huettern/ekg3000-hardware/README.md

EKG-3000 Hardware design
========================

Designed using CADSoft Eagle
