huettern/ekg3000-hardware/05_BOM/BOM_EKG3000.pdf

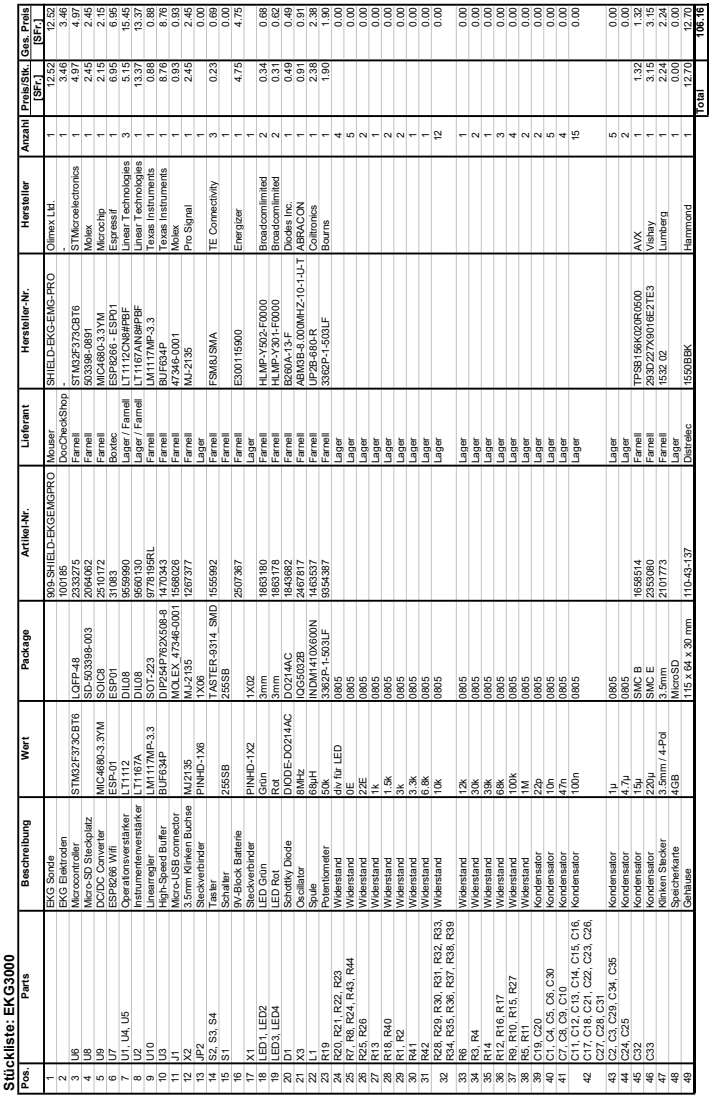
[picture p1: page 1]

Preis/Stk. Ges. Preis

1 EKG Sonde 909-SHIELD-EKGEMGPRO Mouser SHIELD-EKG-EMG-PRO Olimex Ltd. 1 12.52 12.52

3 U6 Microcontroller STM32F373CBT6 LQFP-48 2333275 Farnell STM32F373CBT6 STMicroelectronics 1 4.97 4.97

4 U8 Micro-SD Steckplatz SD-503398-003 2064062 Farnell 503398-0891 Molex 1 2.45 2.45

5 U9 DC/DC Converter MIC4680-3.3YM SOIC8 2510172 Farnell MIC4680-3.3YM Microchip 1 2.15 2.15

6 U7 ESP8266 Wifi ESP-01 ESP01 31083 Boxtec ESP8266 - ESP01 Espressif 1 6.95 6.95

7 U1, U4, U5 Operationsverstärker LT1112 DIL08 9559990 Lager / Farnell LT1112CN8#PBF Linear Technologies 3 5.15 15.45

8 U2 Instrumentenverstärker LT1167A DIL08 9560130 Lager / Farnell LT1167AIN8#PBF Linear Technologies 1 13.37 13.37

9 U10 Linearregler LM1117MP-3.3 SOT-223 9778195RL Farnell LM1117MP-3.3 Texas Instruments 1 0.88 0.88

10 U3 High-Speed Buffer BUF634P DIP254P762X508-8 1470343 Farnell BUF634P Texas Instruments 1 8.76 8.76

11 J1 Micro-USB connector MOLEX_47346-0001 1568026 Farnell 47346-0001 Molex 1 0.93 0.93

12 X2 3.5mm Klinken Buchse MJ2135 MJ-2135 1267377 Farnell MJ-2135 Pro Signal 1 2.45 2.45

14 S2, S3, S4 Taster TASTER-9314_SMD 1555992 Farnell FSM8JSMA TE Connectivity 3 0.23 0.69

16 9V-Block Batterie 2507367 Farnell E300115900 Energizer 1 4.75 4.75

18 LED1, LED2 LED Grün Grün 3mm 1863180 Farnell HLMP-Y502-F0000 Broadcomlimited 2 0.34 0.68

19 LED3, LED4 LED Rot Rot 3mm 1863178 Farnell HLMP-Y301-F0000 Broadcomlimited 2 0.31 0.62

20 D1 Schottky Diode DIODE-DO214AC DO214AC 1843682 Farnell B260A-13-F Diodes Inc. 1 0.49 0.49

24 R20, R21, R22, R23 Widerstand div für LED 0805 Lager 4 0.00

45 C32 Kondensator 15µ SMC B 1658514 Farnell TPSB156K020R0500 AVX 1 1.32 1.32

46 C33 Kondensator 220µ SMC E 2353080 Farnell 293D227X9016E2TE3 Vishay 1 3.15 3.15

47 Klinken Stecker 3.5mm / 4-Pol 3.5mm 2101773 Farnell 1532 02 Lumberg 1 2.24 2.24

49 Gehäuse 115 x 64 x 30 mm 110-43-137 Distrelec 1550BBK Hammond 1 12.70 12.70

Pos. Beschreibung Artikel-Nr. Hersteller Parts Wert Package Lieferant Anzahl Hersteller-Nr.
