huettern/ekg3000-hardware/EKG3000_sch.pdf

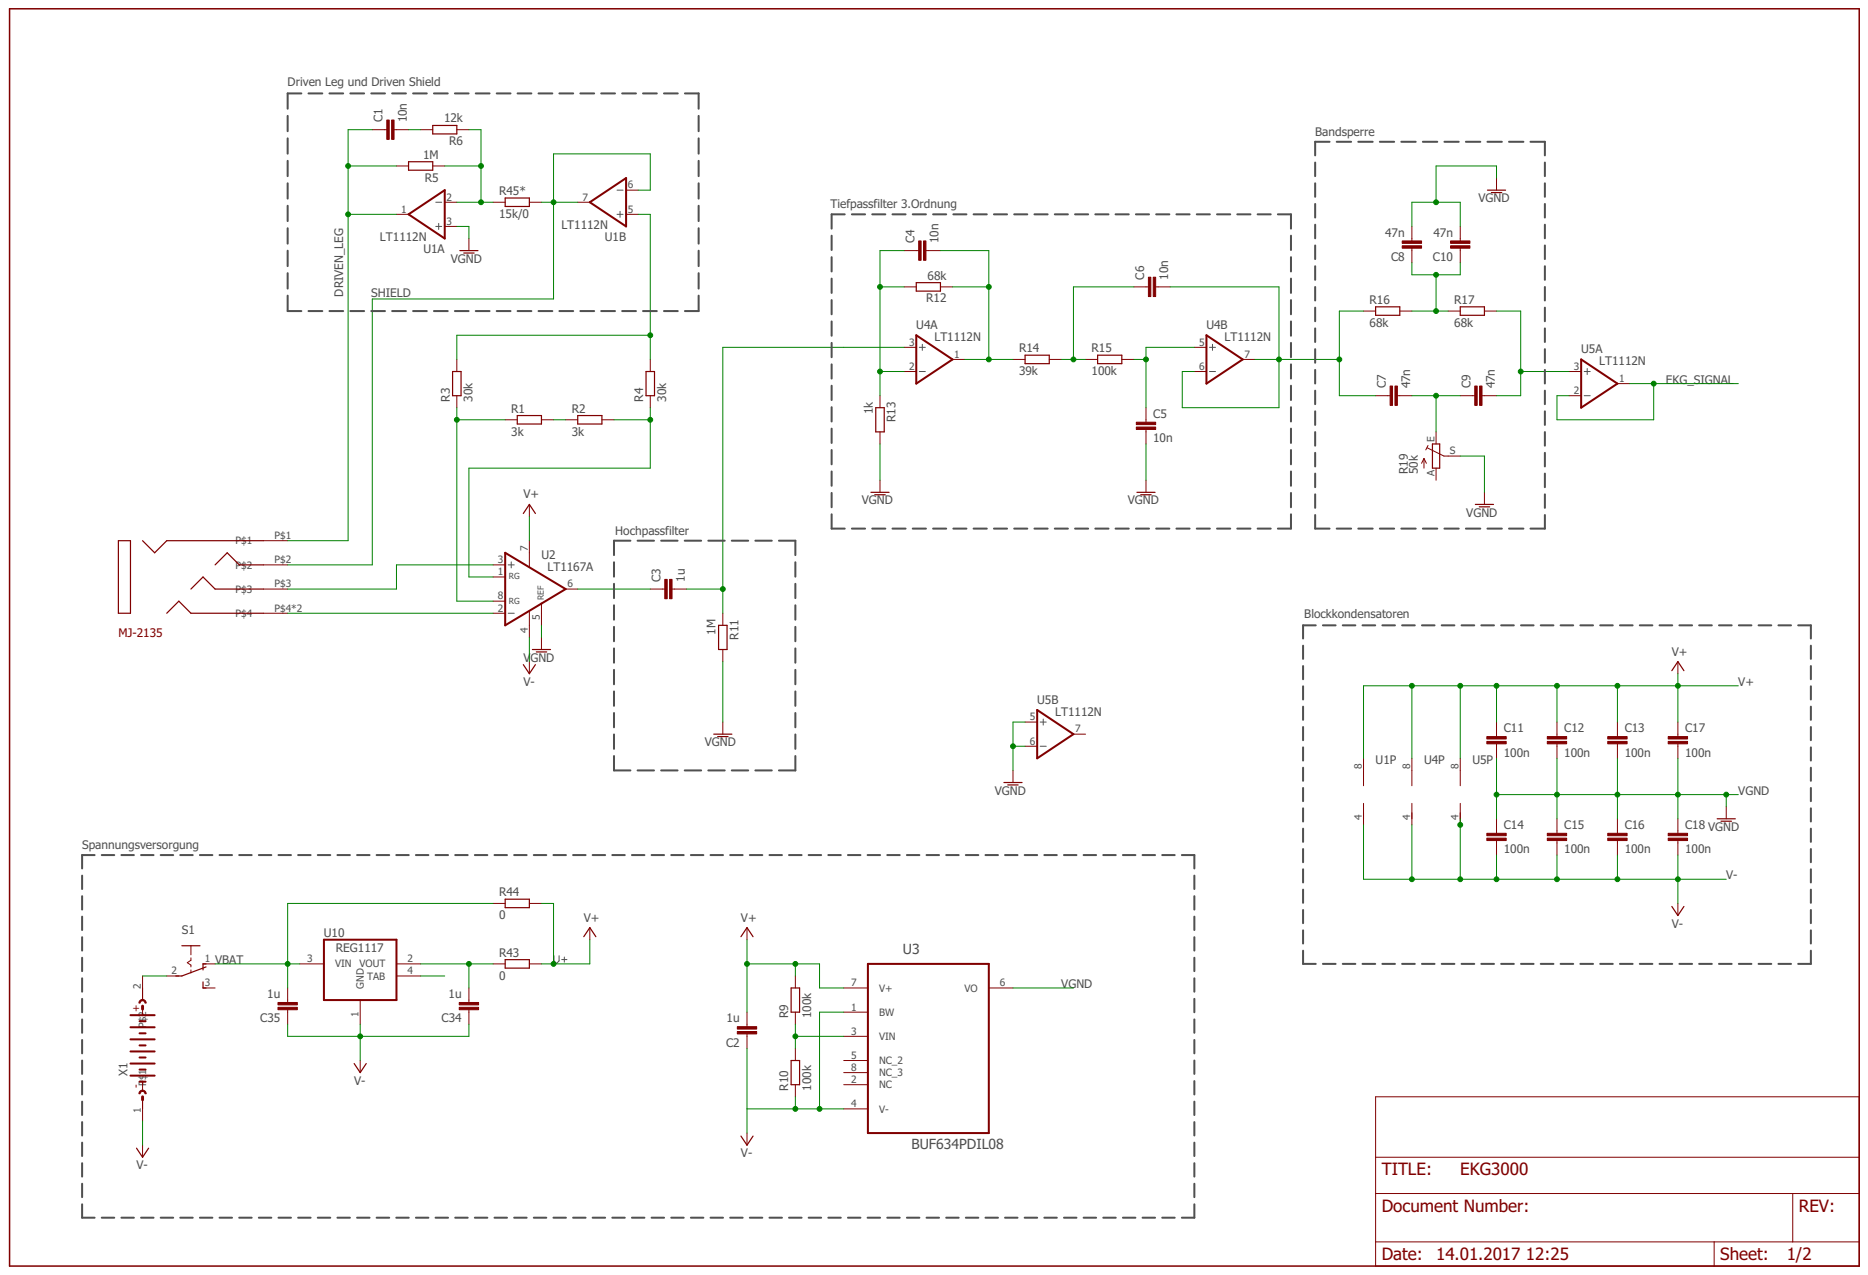
[picture p2: page 1]

Driven Leg und Driven Shield

Document Number: | REV:

Date: 14.01.2017 12:25 | Sheet: 1/2

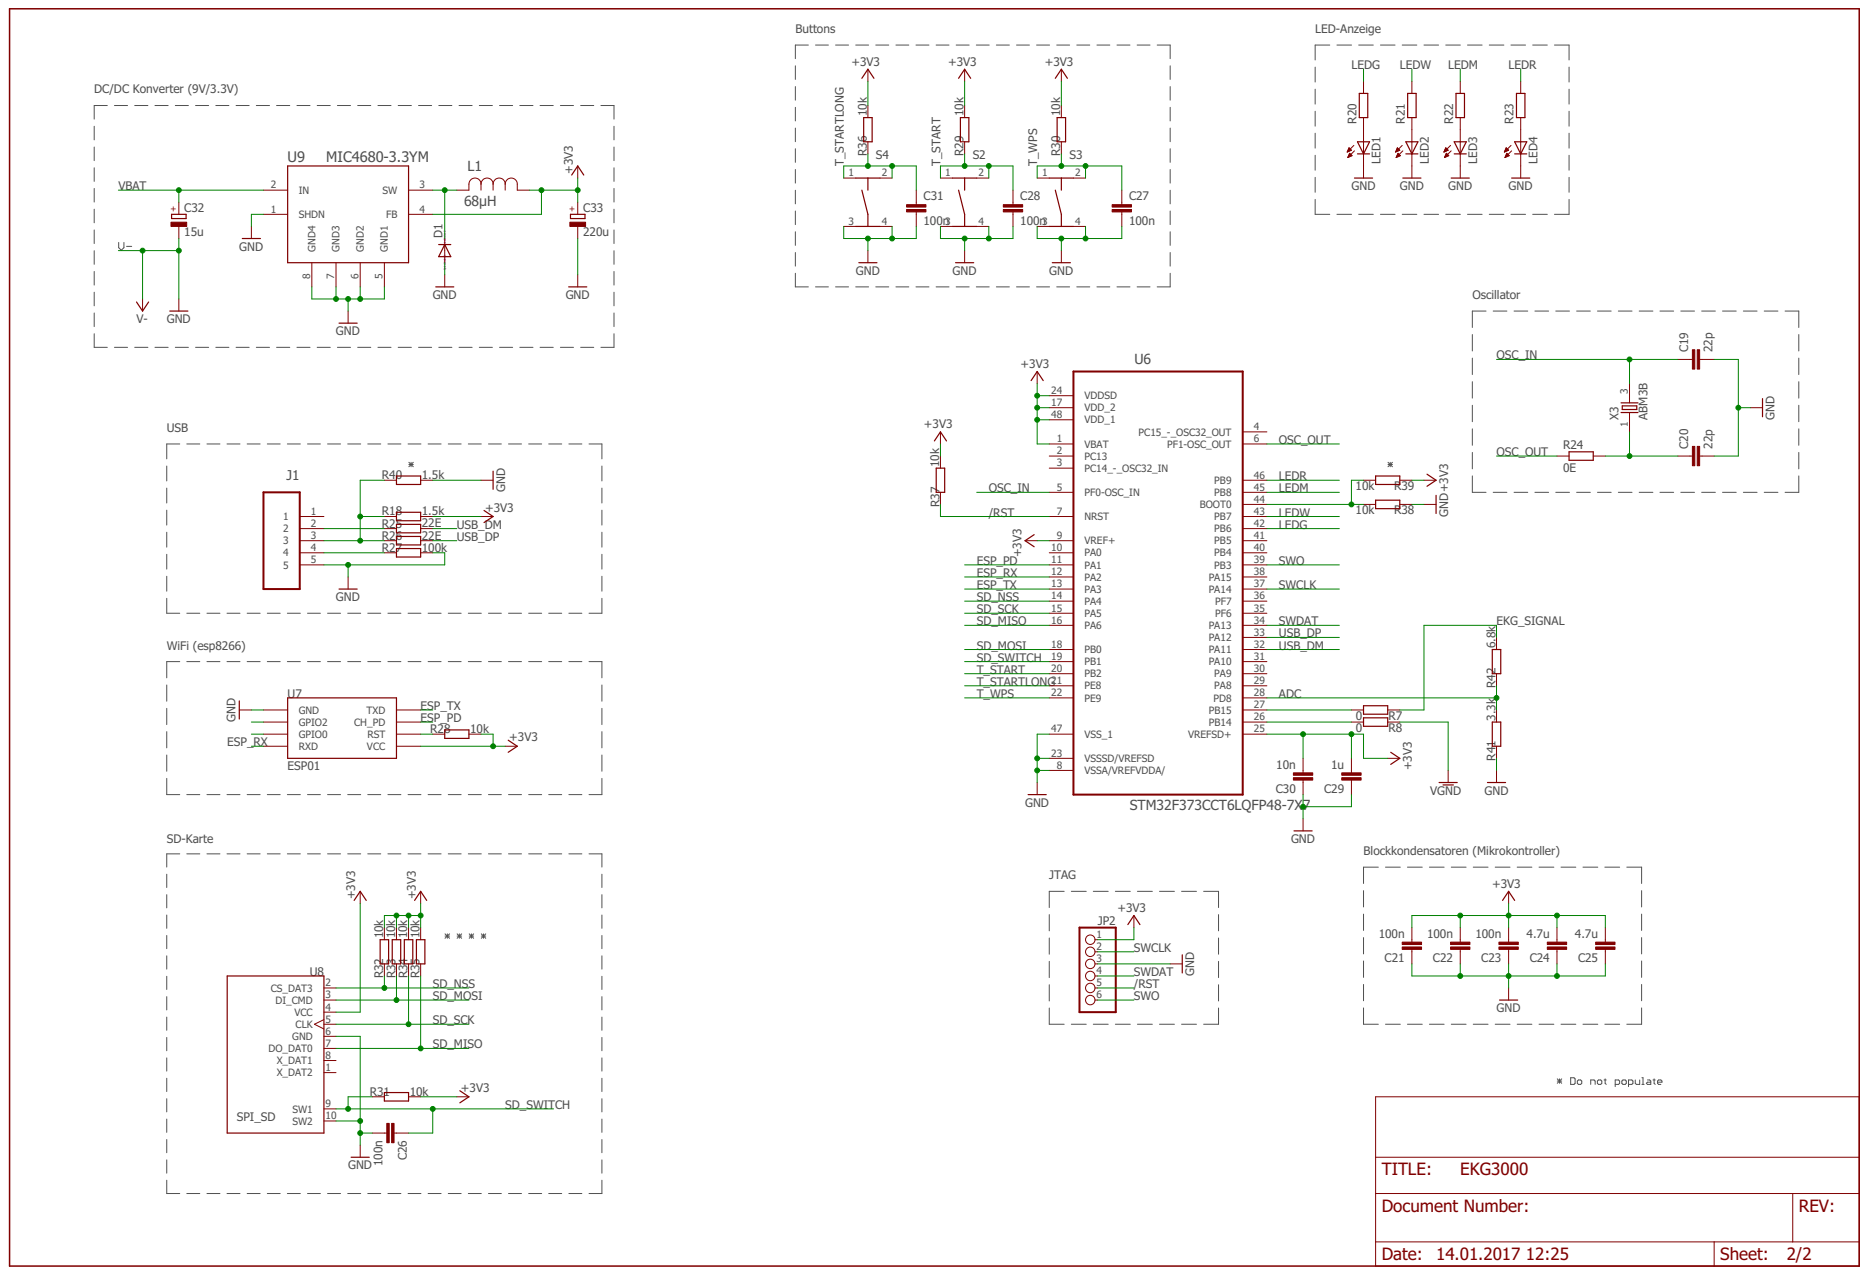
[picture p3: page 2]

SpiceOrder 1 SpiceOrder 2 SPI_SD STM32F373CCT6LQFP48-7X7 GND GND GND 1.5k GND GND +3V3 GND GND +3V3 0E 22p 22p GND GND GND +3V3 +3V3 GND +3V3 100n 100n 100n 4.7u +3V3 4.7u GND +3V3 22E 22E 100k 10k 10k 10k 10k +3V3 GND+3V3 100n 10k 10k 10k 10k +3V3 100n 100n 10n 1u GND GND +3V310k 100n10k +3V3 GND+3V3 10k 10k +3V3GN1.5k D MIC4680-3.3YM 15u 220u 68µH GND GND GND+3V3 GND 3.3k 6.8k GND ABM3B GND 00 +3V3 V- VGND VDDSD 24 VDD_2 17 VDD_1 48 VBAT 1 PC13 2 PC14_-_OSC32_IN 3 PF0-OSC_IN 5 NRST 7 VREF+ 9 PA0 10 PA1 11 PA2 12 PA3 13 PA4 14 PA5 15 PA6 16 PB0 18 PB1 19 PB2 20 PE8 21 PE9 22 VSS_1 47 VSSSD/VREFSD 23 VSSA/VREFVDDA/ 8 VREFSD+ 25 PB14 26 PB15 27 PD8 28 PA8 29 PA9 30 PA10 31 PA11 32 PA12 33 PA13 34 PF6 35 PF7 36 PA14 37 PA15 38 PB3 39 PB4 40 PB5 41 PB6 42 PB7 43 BOOT0 44 PB8 45 PB9 46 PF1-OSC_OUT 6 PC15_-_OSC32_OUT 4 U6 JP2 123456 LED1 LED2 LED3 1 1 2 2 3 3 4 4 5 5 J1 R18 R20 R21 R22 R23 LED4 S2 1 2 3 4 S3 1 2 3 4 GND GPIO2 GPIO0 RXD TXD CH_PD RST VCC U7ESP01U8 CLK 5 CS_DAT3 2 DI_CMD 3 DO_DAT0 7 GND 6 VCC 4 X_DAT1 8 X_DAT2 1 SW1 9 SW2 10 R24 C19 C20 C21 C22 C23 C24 C25 R25 R26 R27 R28 R29 R30 R31 C26 R32 R33 R34 R35 C28 C27 C30 C29 S4 1 2 3 4 R36 C31R37 R38 R39 R40 SHDN 1 IN 2 SW 3 FB 4 GND1 5 GND2 6 GND3 7 GND4 8 U9 C32 C33 L1 D1 R41 R42 X3 3 1 R7R8 SWO SWO /RST /RST SWDAT SWDAT SWCLK SWCLK LEDG LEDG LEDW LEDW LEDM LEDM LEDR LEDR ESP_TX ESP_TX ESP_RX ESP_RX SD_NSS SD_NSS SD_SCK SD_SCK SD_MISO SD_MISO SD_MOSI SD_MOSI USB_DP USB_DP USB_DM USB_DM T_START T_START T_WPS T_WPS ESP_PD ESP_PD ADC OSC_OUT OSC_OUT OSC_IN OSC_IN SD_SWITCH SD_SWITCH T_STARTLONG T_STARTLONG VBAT EKG_SIGNAL Date: 14.01.2017 12:25 Sheet: 2/2REV: TITLE: Document Number: EKG3000 ++ DC/DC Konverter (9V/3.3V) USB WiFi (esp8266) SD-Karte JTAG Blockkondensatoren (Mikrokontroller) Oscillator Buttons LED-Anzeige
