huettern/ekg3000-hardware/schema_v1.brd

## EAGLE design schema_v1.brd (2017-01-19)

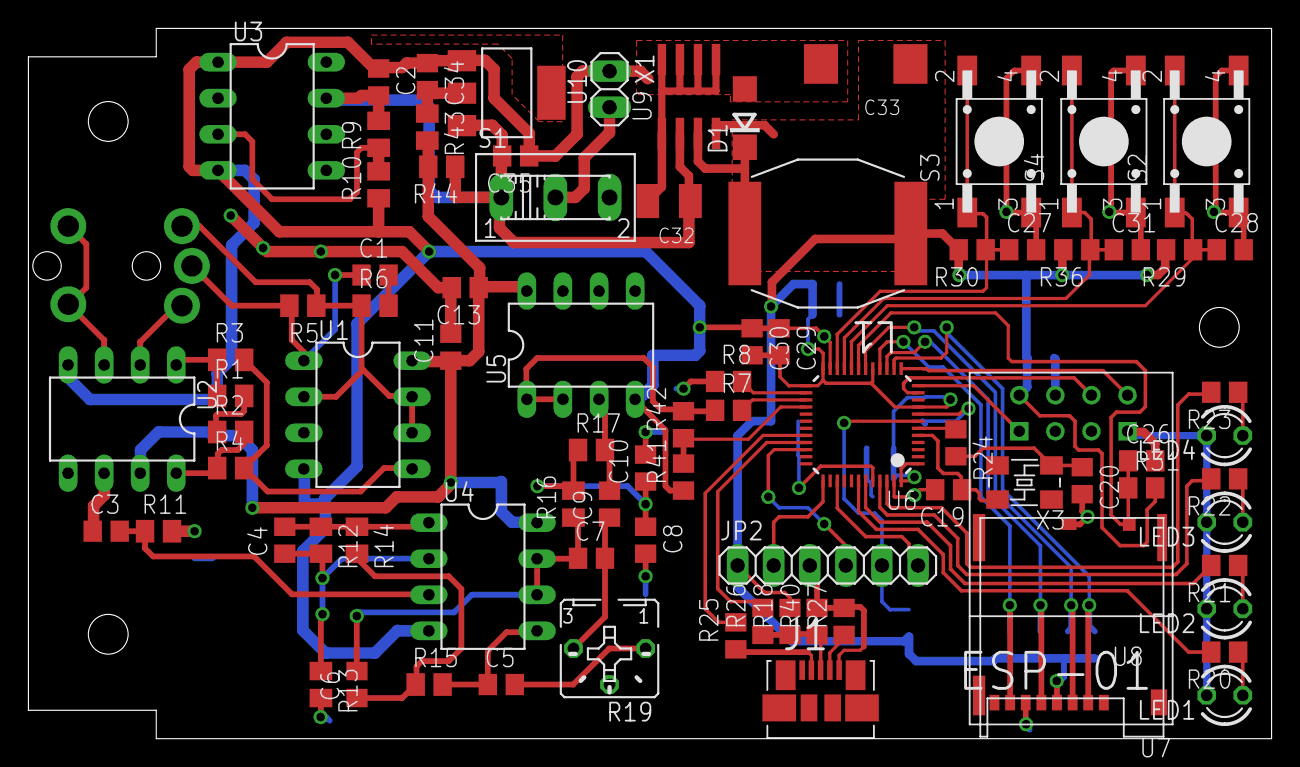
[picture p4: board schema_v1.brd from above]

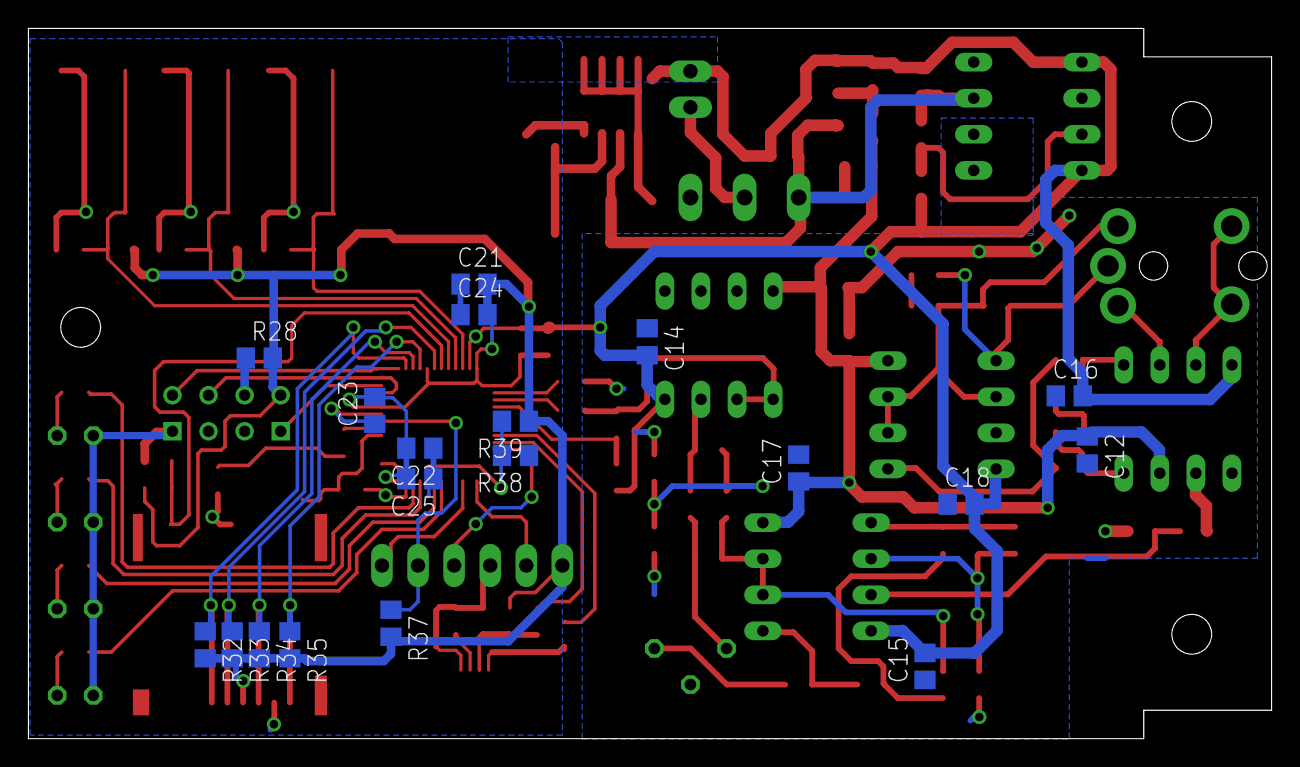
[picture p5: board schema_v1.brd from below]

Board: 2 copper layers, 87.5 x 50.0 mm, 104 parts (19 on the bottom side), 65 nets.

Parts:
C1, C4, C5, C6, C30: 10n; C0805
C2, C3, C29, C34, C35: 1u; C0805
C7, C8, C9, C10: 47n; C0805
C11, C12, C13, C14, C15, C16, C17, C18, C21, C22, C23, C26, C27, C28, C31: 100n; C0805
C19, C20: 22p; C0805
C24, C25: 4.7u; C0805
C32: 15u; SMC_B
C33: 220u; SMC_E
D1: DO214AC
J1: MOLEX_47346-0001
JP2: 1X06
L1: 68µH; INDM1410X600N
LED1, LED2, LED3, LED4: LED3MM
R1, R2: 3k; M0805
R3, R4: 30k; M0805
R5, R11: 1M; M0805
R6: 12k; M0805
R7, R8: 0; R0805
R9, R10, R15: 100k; M0805
R12, R16, R17: 68k; M0805
R13: 1k; M0805
R14: 39k; M0805
R18, R40: 1.5k; R0805
R19: B25P
R20, R21, R22, R23: R0805
R24: 0E; R0805
R25, R26: 22E; R0805
R27: 100k; R0805
R28, R29, R30, R31, R32, R33, R34, R35, R36, R37, R38, R39: 10k; R0805
R41: 3.3k; R0805
R42: 6.8k; R0805
R43, R44: 0; M0805
S1: 255SB
S2, S3, S4: TASTER-9314_SMD
U1, U4, U5: LT1112N; DIL08
U2: LT1167A; DIL08
U3: BUF634PDIL08; DIL08
U6: STM32F373CCT6LQFP48-7X7; LQFP48-7X7
U7: ESP01
U8: MICROSD; SD-503398-003
U9: MIC4680-3.3YM; SOIC8
U10: REG1117; SOT223
X1: 1X02
X2: MJ2135; MJ-2135
X3: ABM3B; IQG5032B

Connections:
+3V3: C21.2, C22.2, C23.2, C24.2, C25.2, C29.2, C30.2, C33.+, JP2.1, L1.1, R18.2, R28.2, R29.2, R30.2, R31.2, R32.2, R33.2, R34.2, R35.2, R36.2, R37.2, R39.1, U6.1, U6.9, U6.17, U6.24, U6.25, U6.48, U7.VCC, U8.4, U9.4
/RST: JP2.5, R37.1, U6.7
ADC: R41.2, R42.1, U6.28
DRIVEN_LEG: C1.1, R5.2, U1.1, X2.P$1
EKG_SIGNAL: R7.1, R42.2, U5.1, U5.2
ESP_PD: U6.11, U7.CH_PD
ESP_RX: U6.12, U7.RX
ESP_TX: U6.13, U7.TX
LEDG: R20.2, U6.42
LEDM: R22.2, U6.45
LEDR: R23.2, U6.46
LEDW: R21.2, U6.43
unnamed: R1.1, R3.1, U2.1
unnamed: C8.1, C10.1, R16.2, R17.1
unnamed: R1.2, R2.1
unnamed: R7.2, U6.27
unnamed: R9.1, R10.2, U3.3
unnamed: C1.2, R6.2
unnamed: R8.2, U6.26
unnamed: U2.2, X2.P$3
unnamed: U2.3, X2.P$4, X2.P$5
unnamed: LED1.A, R20.1
unnamed: C3.1, U2.6
unnamed: C3.2, R11.1, U4.3
unnamed: R2.2, R4.1, U2.8
unnamed: LED2.A, R21.1
unnamed: C6.2, C7.1, R16.1, U4.6, U4.7
unnamed: C4.2, R12.1, R14.1, U4.1
unnamed: R3.2, R4.2, U1.5
unnamed: S1.2, X1.2
unnamed: C6.1, R14.2, R15.1
unnamed: C5.1, R15.2, U4.5
unnamed: LED3.A, R22.1
unnamed: C9.2, R17.2, U5.3
unnamed: C7.2, C9.1, R19.E
unnamed: LED4.A, R23.1
unnamed: J1.4, R27.1
unnamed: J1.3, R18.1, R26.1, R40.1
unnamed: J1.2, R25.1
unnamed: R28.1, U7.RST
unnamed: C20.1, R24.2, X3.1
unnamed: R38.2, R39.2, U6.44
unnamed: D1.C, L1.2, U9.3
unnamed: C34.2, R43.1, U10.2
unnamed: C4.1, R12.2, R13.1, U4.2
OSC_IN: C19.1, U6.5, X3.3
OSC_OUT: R24.1, U6.6
SD_MISO: R35.1, U6.16, U8.7
SD_MOSI: R33.1, U6.18, U8.3
SD_NSS: R32.1, U6.14, U8.2
SD_SCK: R34.1, U6.15, U8.5
SD_SWITCH: C26.1, R31.1, U6.19, U8.9
SHIELD: R5.1, R6.1, U1.2, U1.6, U1.7, X2.P$2
SWCLK: JP2.2, U6.37
SWDAT: JP2.4, U6.34
SWO: JP2.6, U6.39
T_START: C28.1, R29.1, S2.1, S2.2, U6.20
T_STARTLONG: C31.1, R36.1, S4.1, S4.2, U6.21
T_WPS: C27.1, R30.1, S3.1, S3.2, U6.22
USB_DM: R25.2, U6.32
USB_DP: R26.2, U6.33
V+: C11.1, C12.1, C13.1, C17.1, R43.2, R44.2, U1.8, U2.7, U4.8, U5.8
V-: C2.1, C14.2, C15.2, C16.2, C18.2, C19.2, C20.2, C21.1, C22.1, C23.1, C24.1, C25.1, C26.2, C27.2, C28.2, C29.1, C30.1, C31.2, C32.-, C33.-, C34.1, C35.1, D1.A, J1.5, JP2.3, LED1.K, LED2.K, LED3.K, LED4.K, R10.1, R27.2, R38.1, R40.2, R41.1, S2.3, S2.4, S3.3, S3.4, S4.3, S4.4, U1.4, U2.4, U3.1, U3.4, U4.4, U5.4, U6.8, U6.23, U6.47, U7.GND, U8.6, U8.10, U9.1, U9.5, U9.6, U9.7, U9.8, U10.1, X1.1
VBAT: C2.2, C32.+, C35.2, R9.2, R44.1, S1.1, U3.7, U9.2, U10.3
VGND: C5.2, C8.2, C10.2, C11.2, C12.2, C13.2, C14.1, C15.1, C16.1, C17.2, C18.1, R8.1, R11.2, R13.2, R19.A, U1.3, U2.5, U3.6, U5.5, U5.6
