huettern/ekg3000-hardware/(commit log)

2016-10-30 libary and schematic
    [ekg3000.sch]
2017-01-19 final files for prototype
    [schema_v1.brd, schema_v1.sch]
